chpoit/snowcat-esp32-controller/(commit log)

2022-02-03 added esp32, removed useless makefiles
2022-02-04 esc control basically done
2022-02-04 moved throttle to first core, fixed watchdog issue
    [arduino_main.cpp]
2022-02-04 Moved calibration stuff
2022-02-04 Generic kicad stuff
    [esp32-circuit.kicad_pcb, esp32-circuit.kicad_sch]
2022-02-11 a couple extra accelerations
2022-02-21 start work on racecar, implemented controltype switching
